nunera/Determine/cloud/inference/requirements-cpu.txt

# Local development / smoke test on CPU (no Neuron devices). Install torch from the CPU index:
#   pip install --index-url https://download.pytorch.org/whl/cpu torch
torch
transformers>=4.57
pillow
num2words
