nunera/Determine/cloud/API.md

# Describe loop — cloud contract v1 (Arch §7.3)

Optional, on-request scene description. Never in the hazard loop: the phone keeps warning while a request is in
flight, and any MID or NEAR hazard interrupts the answer.

```
phone ──HTTPS──▶ describe-api (AWS Lambda, arm64 / Graviton2) ──HTTP──▶ inference server (EC2 inf2.xlarge, Inferentia2)
                                                    └──(optional fallback)──▶ Amazon Bedrock Nova Lite (silicon not guaranteed)
                                                    └──(configured primary)─▶ OpenRouter → configured vision model
```

## 1. Phone → describe-api

`POST /v1/describe` · `Authorization: Bearer <DESCRIBE_API_KEY>` · `Content-Type: application/json`

Request:

| Field | Type | Rule |
|---|---|---|
| `request_id` | string | 8–64 chars `[A-Za-z0-9_-]`, chosen by the phone |
| `image_jpeg_b64` | string | base64 JPEG, decoded size ≤ 512 KiB, must start `FFD8` |
| `width`, `height` | int | 16–2048 |
| `redacted` | bool | `true`: the phone blurred faces before upload. `false` is accepted only together with `unredacted_opt_in: true`, otherwise 400 |
| `unredacted_opt_in` | bool, optional | `true` only when the wearer has explicitly opted in to uploading frames with faces unblurred (default off in the app). Ignored when `redacted` is `true` |
| `question` | string, optional | A specific question about the photo (1–300 characters of plain text; double quotes become single). It is added to the §3 prompt as data, and the answer still passes the §3 filter. Never logged |
| `locale` | string | `en` only in v1 |

Response 200:

```json
{"request_id":"…","text":"A doorway is open on your right. A person is farther ahead near the wall.",
 "sentences":["A doorway is open on your right.","A person is farther ahead near the wall."],
 "model":"HuggingFaceTB/SmolVLM-256M-Instruct","backend":"inf2","silicon":"Inferentia2",
 "timings_ms":{"inference":812,"api":43,"total":855}}
```

- `backend` ∈ `inf2` | `trn2` | `bedrock` | `openrouter` | `cpu` (dev only). `silicon` ∈ `Inferentia2` | `Trainium2` | `unspecified` | `CPU`. With `openrouter` the `model` is the model OpenRouter actually served.
- `text` is at most 2 sentences, ≤ 240 characters, after the API's safety filter (§3). The phone speaks it as
  returned; neither the API nor the phone adds a prefix.
- Errors: JSON `{"request_id":…|null,"error":"<code>","retryable":bool}` with status 400 `bad_request`,
  401 `unauthorized`, 413 `too_large`, 502 `inference_failed`, 503 `unavailable`, 504 `timeout`.
- The API stores no images and logs no image bytes or text; it logs request_id, sizes, backend and timings.
- Phone timeout: 8 s end to end. API → inference timeout: 6 s.

### 1b. Voice routing: `POST /v1/voice`

Same bearer key and error format. What the wearer said after the wake phrase goes to Jev, TypeSafe's decision model
(`typesafe/jev-1.14`, set with `OPENROUTER_ROUTER_MODEL`), through OpenRouter's Decisions API
(`POST https://openrouter.ai/api/alpha/decisions`). Jev is not a chat model: it answers one typed Choice question,
"which of these routes does the wearer want", with the chosen route and a probability for every route, in about 0.3 s
(measured from the home server). Only the transcript text is sent: no audio and no image. The phone tries its own
fixed phrases first and calls this only when none matched.

Request: `{"request_id":str,"transcript":str (1–300 chars),"locale":"en"}`

Response 200:

```json
{"request_id":"…","action":"command","command":"pauseWarnings","model":"typesafe/jev-1.14-20261014","backend":"openrouter",
 "confidence":0.99,"timings_ms":{"inference":270,"api":3,"total":273}}
```

- Routes: `whatsAhead`, `readText`, `pauseWarnings`, `resumeWarnings`, `stopSpeaking`, `askAboutScene`, `none`.
- `action` is `command` (the first five routes), `ask` (`askAboutScene`: the phone then calls `/v1/describe` with one
  frame and `question`, which is what the wearer said as cleaned plain text), or `none`. `confidence` is Jev's
  probability for the chosen route.
- "Is this path safe / clear / okay to cross?" routes to `whatsAhead`, not `askAboutScene`: a photo cannot show that
  something is safe, and the §3 filter drops any sentence that says so, so a yes-or-no question would come back empty
  or missing the hazard. The wearer gets the same description as for "what's ahead", which never says safe or clear.
- The route is acted on only when `confidence` ≥ `VOICE_MIN_CONFIDENCE` (default 0.6); otherwise `action` is `none`.
  Anything else unusable (a route that is not one of the seven, a missing or non-numeric probability, a malformed
  answer) is also `none`: the phone does nothing.
- The transcript is untrusted but cannot instruct anything: it is Jev's state, and the only possible output is one of
  the seven routes. It is never logged; only its length is. The Decisions API has no data-collection option, so the
  transcript goes to TypeSafe under OpenRouter's default policy.
- Budget 4 s; failures use the same codes (`unavailable` for a missing key, rate limit or no credits, `timeout`).

### 1c. Streamed descriptions: `POST /v1/describe/stream`

Implemented by `describe-api/local_server.py` with `DESCRIBE_BACKEND=openrouter`. The Lambda handler and its
existing JSON endpoint remain buffered; deploying the SAM template alone does not enable this streaming route.
Same bearer key, image limits, locale and privacy validation as §1. Additional request fields:

| Field | Choices | Default |
|---|---|---|
| `length` | `brief` (1 sentence / 180 characters), `standard` (2 / 360), `detailed` (5 / 1000) | `standard` |
| `style` | `direct`, `conversational`, `spatial` (image positions, not walking directions) | `direct` |

The prompt applies these preferences. Before emission, every complete sentence passes the existing reassurance
and person-attribute heuristics. The first increment therefore waits for a complete sentence, not just a token.
These heuristics are conservative checks, not safety certification. No unfiltered token is emitted first.

Response: `Content-Type: application/x-ndjson`, `Cache-Control: no-store`; each line is one JSON object:

```json
{"type":"delta","text":"A chair is on the left."}
{"type":"delta","text":" A door is ahead."}
{"type":"done","text":"A chair is on the left. A door is ahead.","request_id":"example_123"}
```

Concatenate deltas exactly (including leading spaces); `done.text` must equal that concatenation.
Failures before the first safe sentence use the ordinary JSON/status contract. A later failure sends
`{"type":"error","error":"inference_failed","retryable":true}` and closes the stream, with no `done`.
An EOF without `done` is a failure, not a complete answer. Cancelling the client closes its connection;
the server closes upstream on its next attempted write. The upstream request has a 20 s socket timeout and
checks elapsed time between events; the client has a 25 s idle / 45 s resource timeout. No automatic retries.
OpenRouter cancellation/billing depends on its selected upstream provider.
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
