nunera/Determine/docs/images/brief-2.png

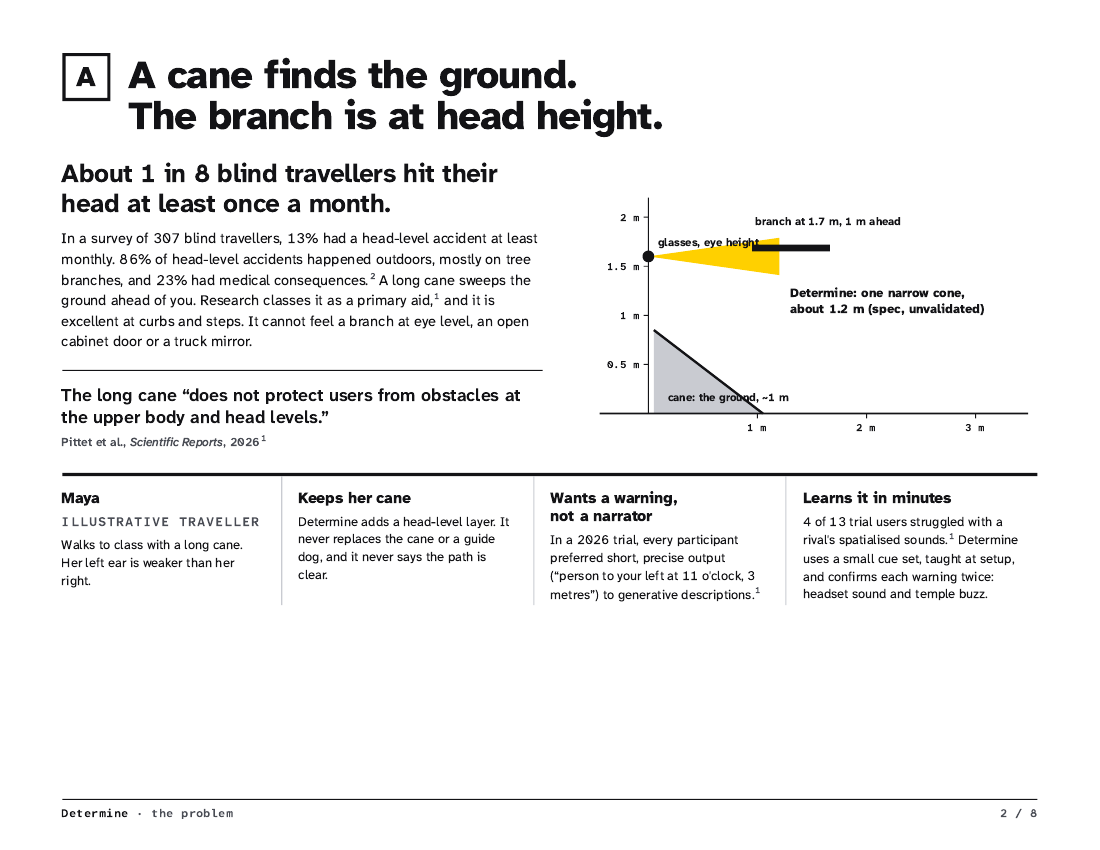
docs/images/brief-2.png
