nunera/Determine/docs/images/brief-5.png

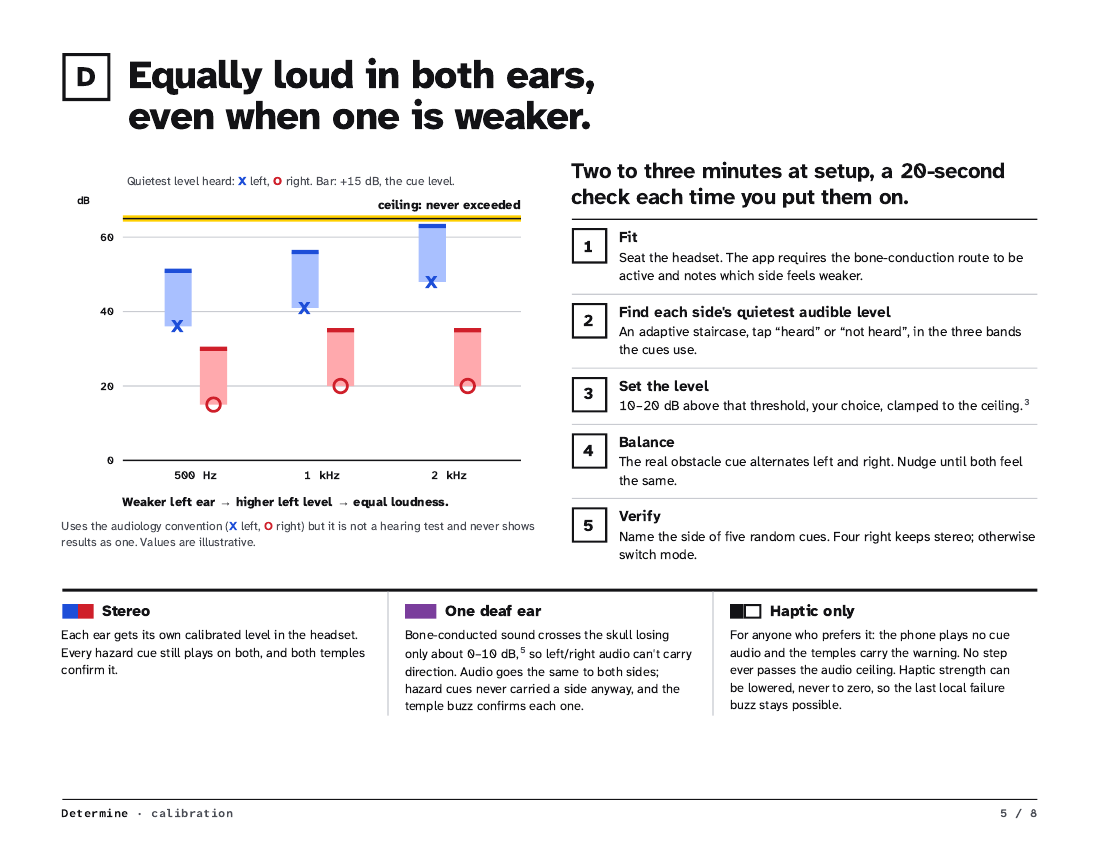
docs/images/brief-5.png
