nunera/Determine/docs/images/brief-7.png

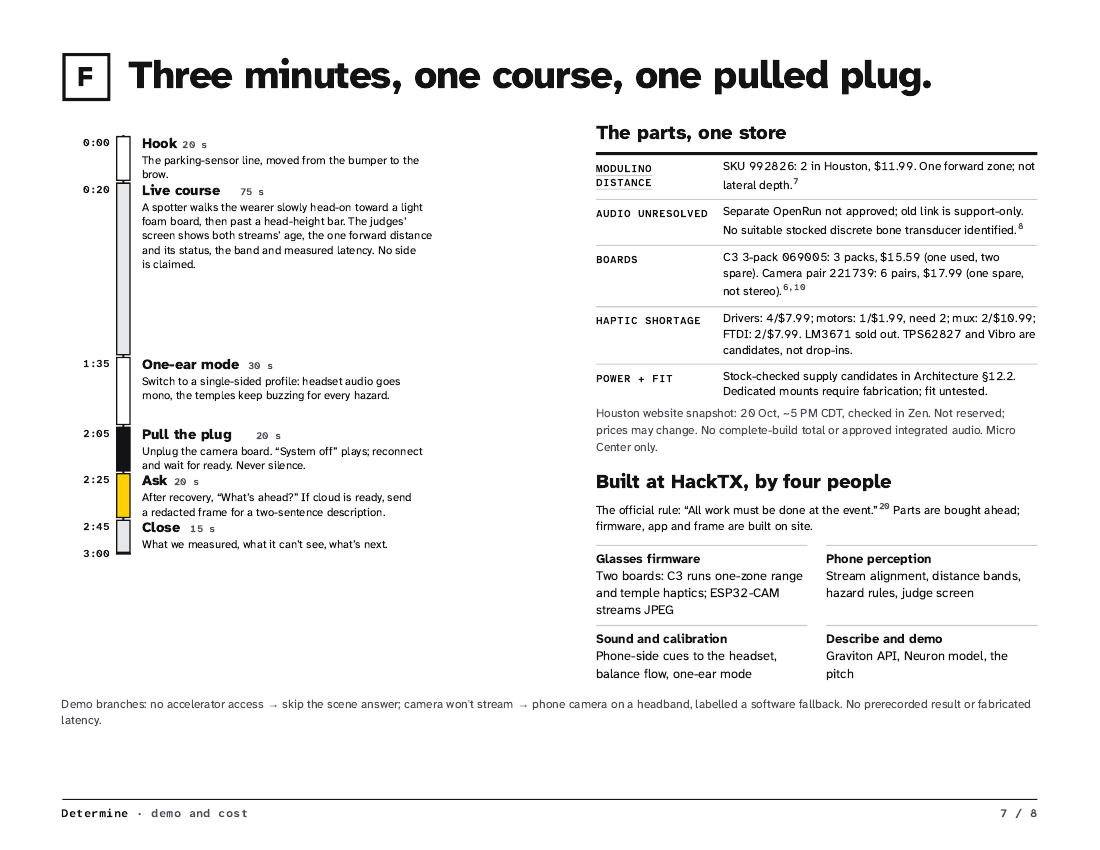
docs/images/brief-7.png
