nunera/Determine/docs/images/brief-8.png

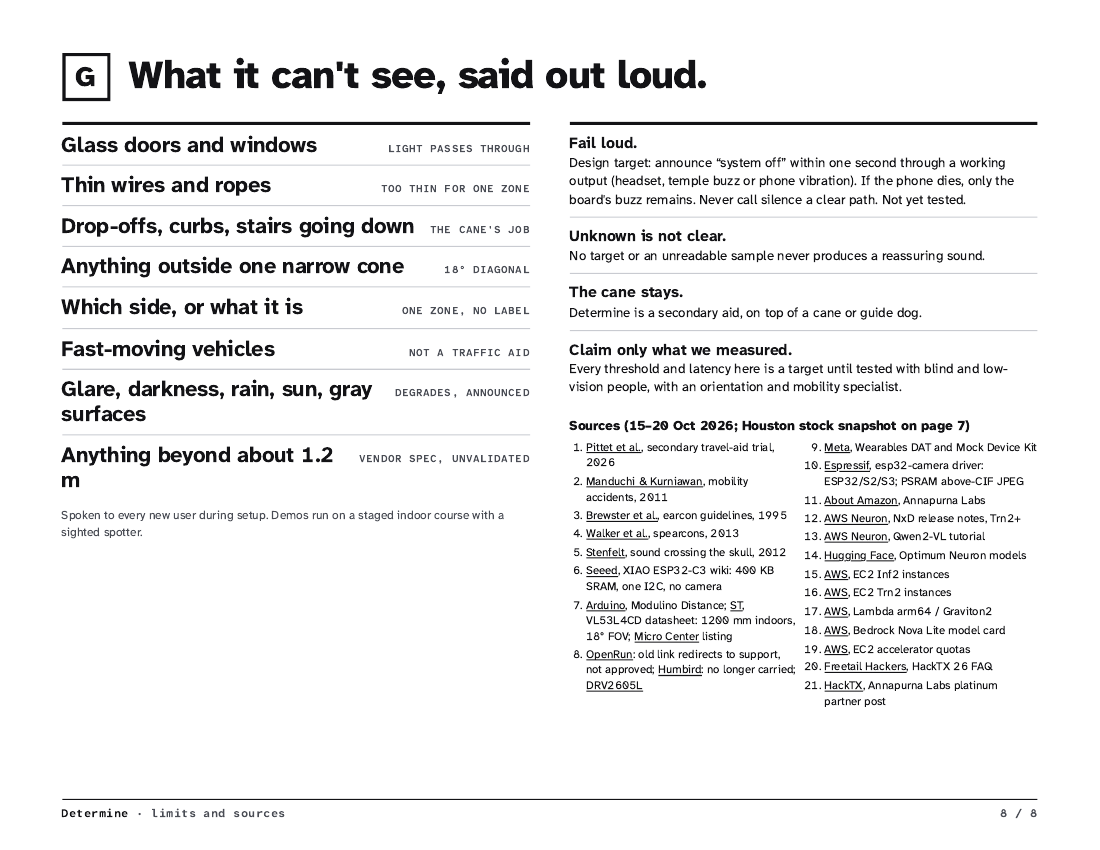
docs/images/brief-8.png
