nunera/Determine/docs/images/desktop-judge-near.png

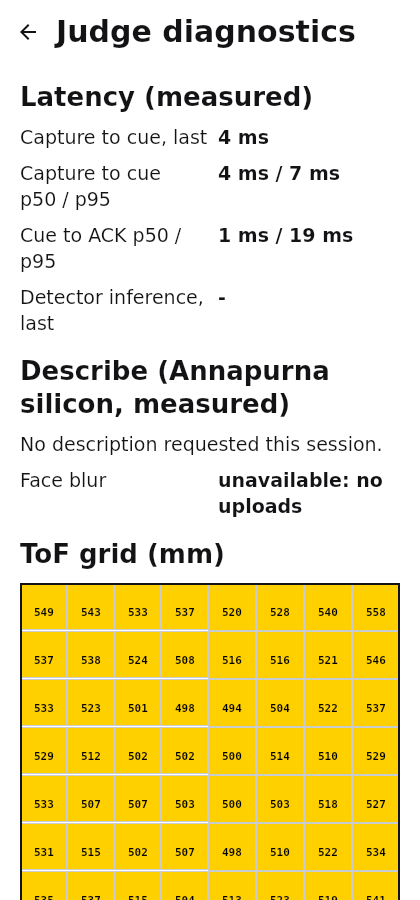
docs/images/desktop-judge-near.png
