nunera/Determine/docs/images/desktop-judge.png

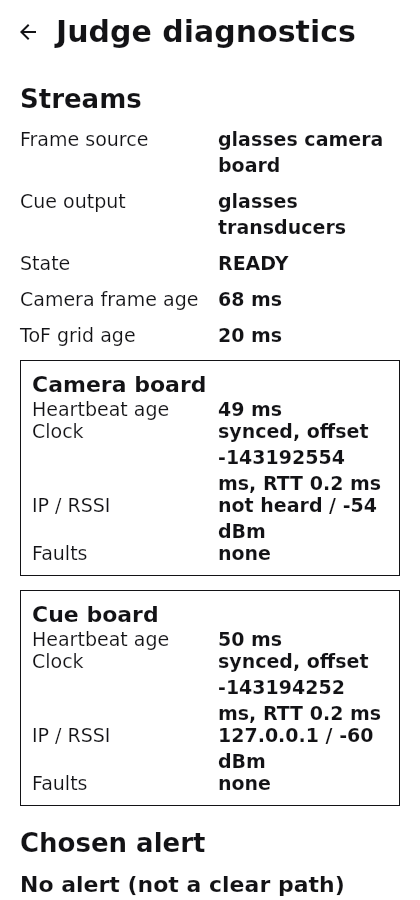
docs/images/desktop-judge.png
