nunera/Determine/docs/images/desktop-main.png

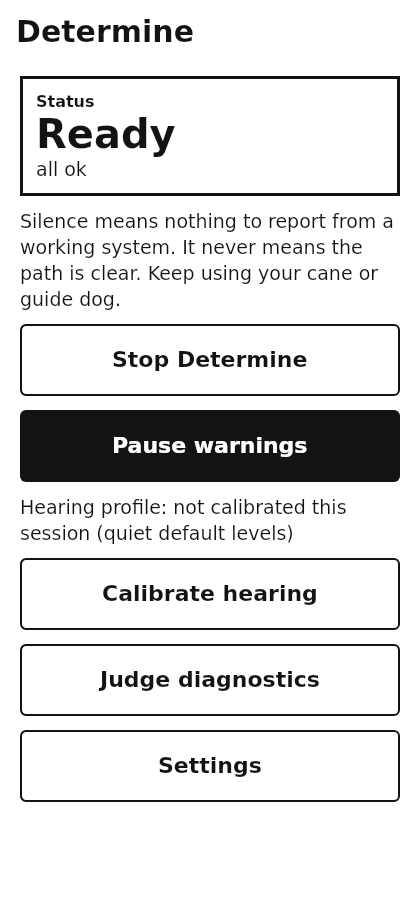
docs/images/desktop-main.png
