nunera/Determine/web/public/model/Right_LensFrontWindow.stl

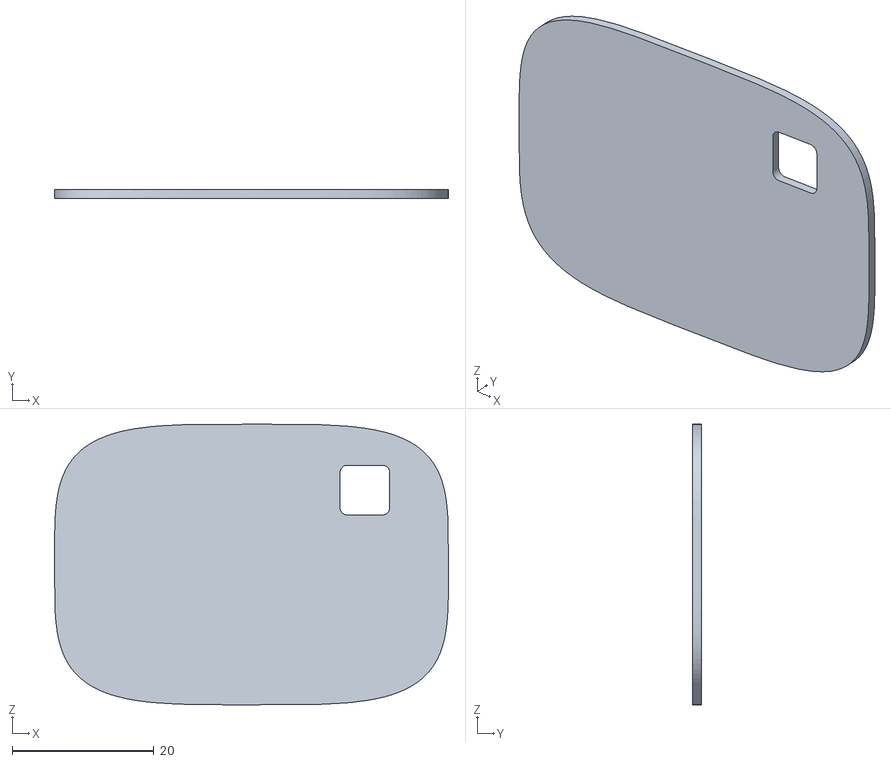
[picture p21: CAD file, 2026-10-25]
web/public/model/Right_LensFrontWindow.stl
55.6 x 1.20 x 39.6
