nunera/Determine/web/public/model/Left_HingePin.stl

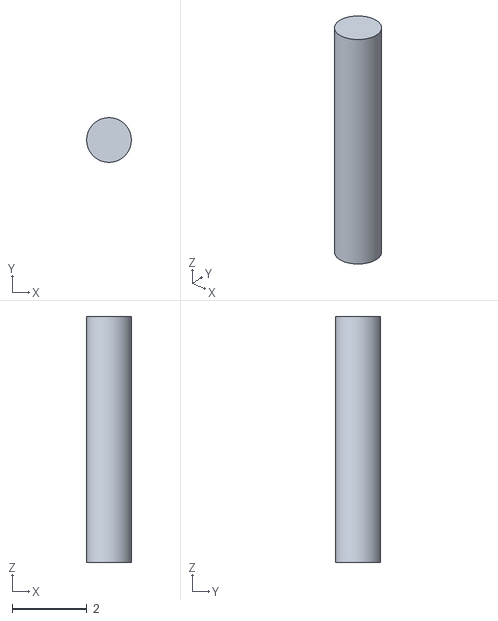
[picture p22: CAD file, 2026-10-25]
web/public/model/Left_HingePin.stl
1.20 x 1.20 x 6.60
