nunera/Determine/web/public/model/Right_RemovableTempleCover.stl

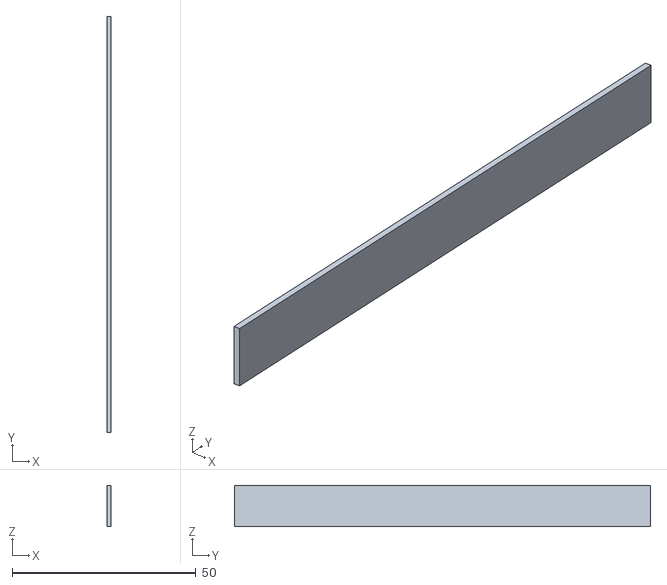
[picture p23: CAD file, 2026-10-25]
web/public/model/Right_RemovableTempleCover.stl
1.20 x 113.2 x 11.2
