nunera/Determine/web/public/model/Left_LensChamber.stl

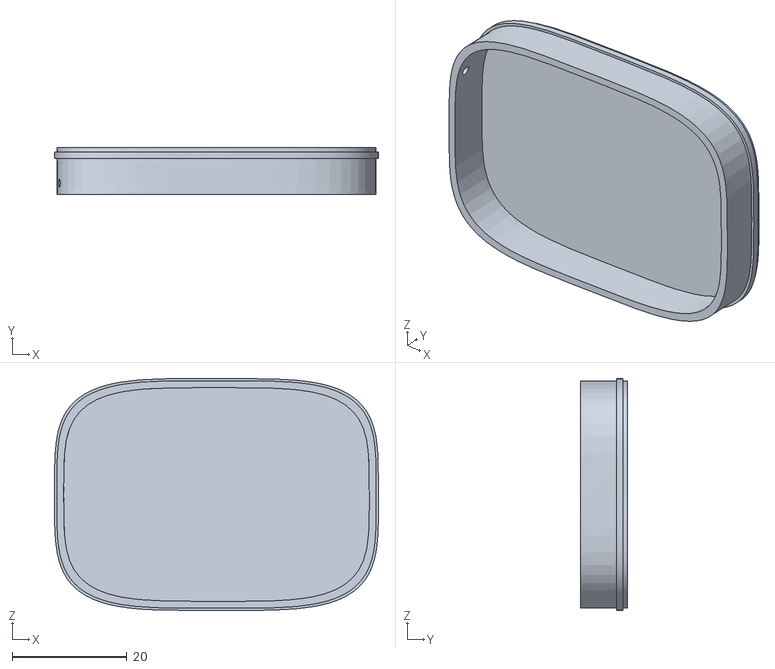
[picture p24: CAD file, 2026-10-25]
web/public/model/Left_LensChamber.stl
56.4 x 8.10 x 40.4
