nunera/Determine/web/public/model/Left_ClearTemple.stl

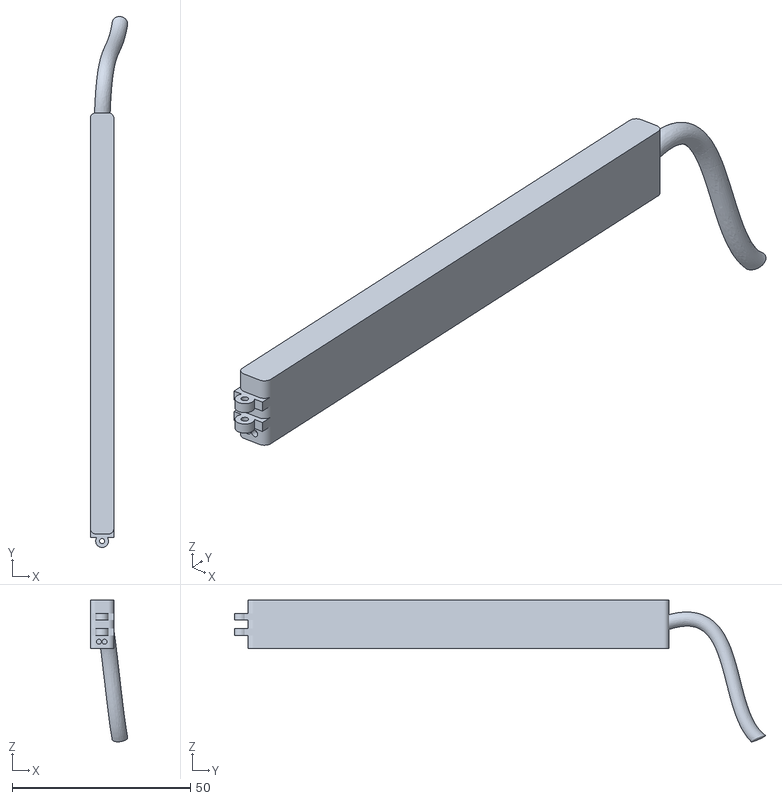
[picture p25: CAD file, 2026-10-25]
web/public/model/Left_ClearTemple.stl
10.5 x 148.8 x 39.7
