nunera/Determine/web/public/model/ForwardCamera_OpticalGasket.stl

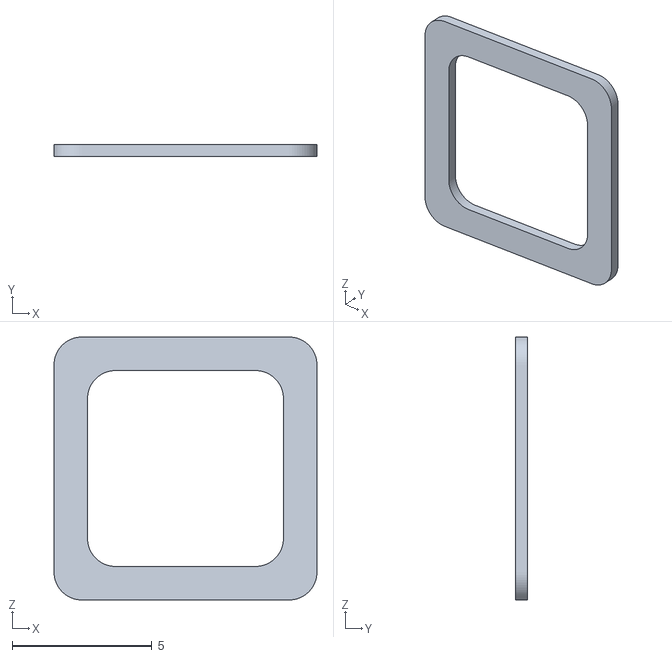
[picture p26: CAD file, 2026-10-25]
web/public/model/ForwardCamera_OpticalGasket.stl
9.40 x 0.43 x 9.40
