nunera/Determine/web/public/model/Front_ClearFrame.stl

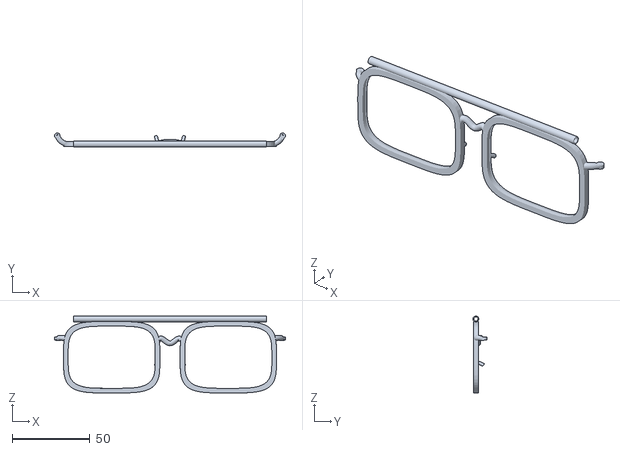
[picture p27: CAD file, 2026-10-25]
web/public/model/Front_ClearFrame.stl
148.6 x 9.10 x 49.5
