nunera/Determine/web/public/model/Left_NosePad.stl

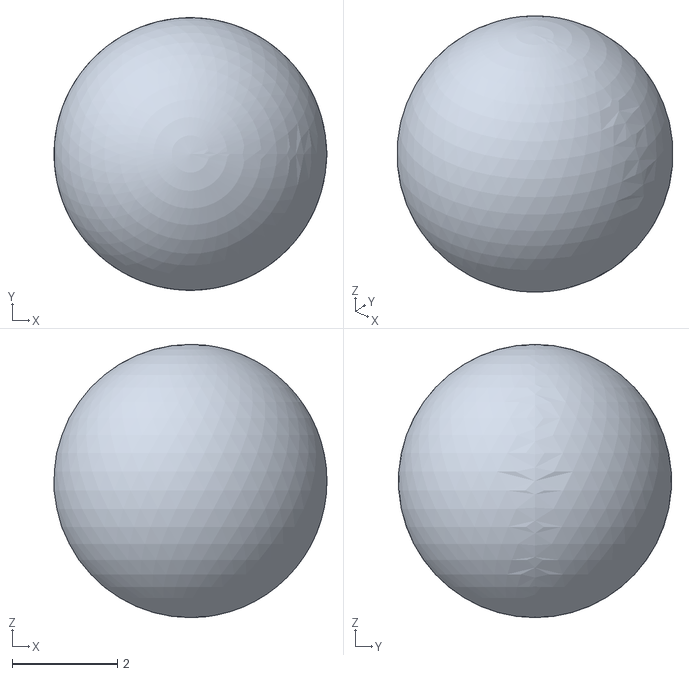
[picture p28: CAD file, 2026-10-25]
web/public/model/Left_NosePad.stl
5.19 x 5.18 x 5.20
