nunera/Determine/web/public/model/ForwardToF_OpticalGasket.stl

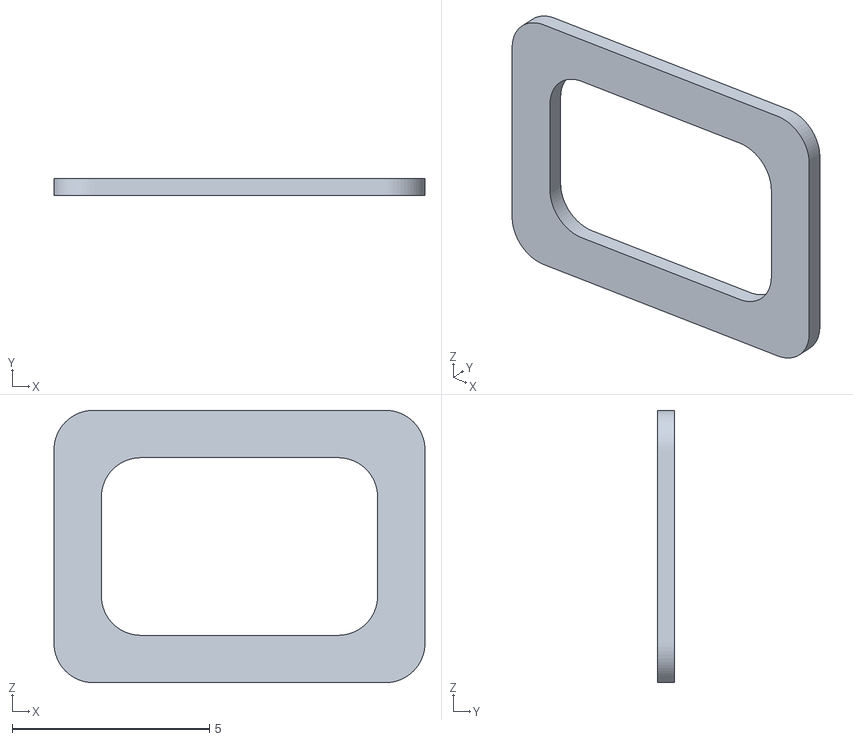
[picture p29: CAD file, 2026-10-25]
web/public/model/ForwardToF_OpticalGasket.stl
9.40 x 0.43 x 6.90
