nunera/Determine/(list of files, cad)

Other CAD files:
web/public/model/Right_LensChamber.stl
web/public/model/Right_HingePin.stl
web/public/model/Left_LensFrontWindow.stl
web/public/model/Right_ClearTemple.stl
web/public/model/Left_RemovableTempleCover.stl
web/public/model/Right_NosePad.stl
