nunera/Determine/docs/visual-guide/assets/simulation.png

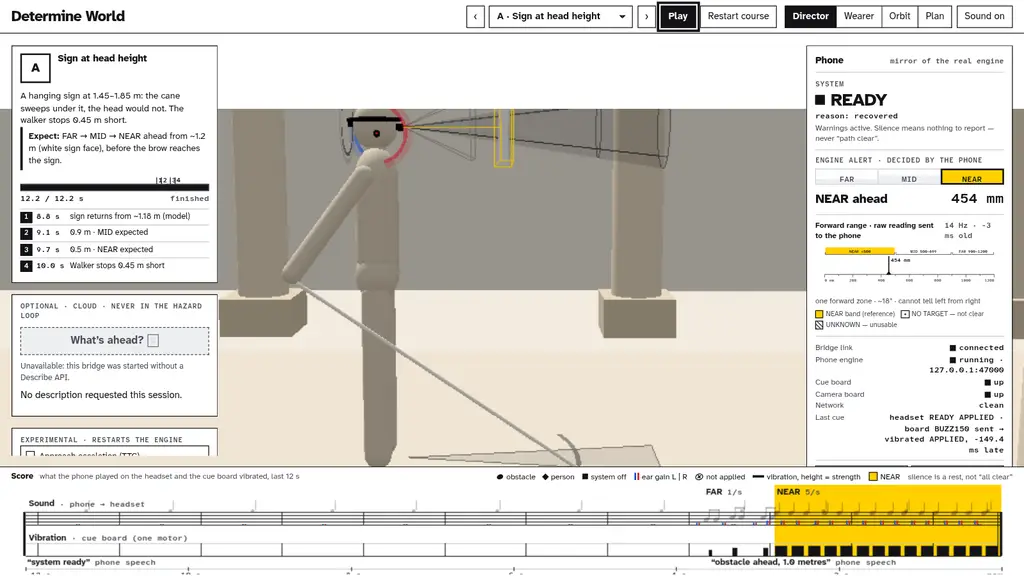
docs/visual-guide/assets/simulation.png
