nunera/Determine/firmware/common/include/secrets.example.h

// Copy to secrets.h (gitignored) and fill in the phone hotspot credentials.
// Arch §10.1: WPA2 hotspot with a unique password.
#pragma once
#define DT_WIFI_SSID "determine-hotspot"
#define DT_WIFI_PASS "change-me-unique"
