nunera/Determine/(commit log)

2026-10-24 Document compact Houston-first parts list
    Add the full compact two-board purchase list (Architecture §12.2), compact headband layout and power notes, matching brief parts and diagram, and product context. Regenerate both PDFs.
2026-10-24 Audit docs for consistency and add Annapurna collaboration research
    - Fix stale price total, power-loss wording, ESP32-CAM status, latency budget
    - NEAR cue becomes one urgent note at 5/s (fits the 6 notes/s rule)
    - Optional MOSFET haptic fallback parts; canonical six-segment demo script
    - Brief layout fixes (clipped/overlapping labels, footer overflow, rest glyph font)
    - New Architecture §11.6: Annapurna Labs collaborations; Gemma3 as second Inf2 candidate
2026-10-24 Add wire protocol v1, ESP32 firmware, simulator and flow diagrams
    - protocol/: PROTOCOL.md, Python reference codec, golden vectors
    - firmware/cue-board (XIAO ESP32-C3) and firmware/cam-board (ESP32-CAM), PlatformIO, native Unity tests
    - tools/sim: two-board simulator, bench tool for real boards, end-to-end harness (8 scenarios)
    - docs/flows: 6 hardware flow maps and 9 software flowcharts, rendered SVGs; README gallery with brief pages
2026-10-24 Add phone hazard engine and headless CLI
    - phone/core: wire codec, clock sync, frame assembly, ToF corridor, hazard policy (Arch §7.2),
    cue scheduler (Arch §8), calibration (Arch §9), system states (Arch §4.2)
    - Tier 0 phone-camera and phone-audio cue fallbacks; Describe controller (opt-in, interruptible)
    - phone/cli: determine-phone, stable event output for tools/sim/e2e.py (8/8 scenarios pass)
2026-10-24 Add Android app
    Foreground service, MediaPipe detector, TTS/vibration, judge + calibration + settings UI.
    Describe: long-press 'What's ahead?', BlazeFace face blur on the phone, HTTPS client, spoken 'May be wrong.'
    Fallbacks: CameraX phone camera (Tier 0) and phone-audio cue sink, labelled as software fallbacks.
2026-10-24 Add Describe loop on Annapurna silicon
    - cloud/API.md contract; describe-api on Lambda arm64 (Graviton2) with SAM template and safety filter
    - inference server for SmolVLM-256M via optimum-neuron on inf2.xlarge, compile + setup + bench scripts
    - CPU dev path measured end to end (p50 2.0 s); Inferentia2 unmeasured until quota
2026-10-24 Fix camera-reboot lockout and emulator crash; add app screenshots
    - phone/core: after a board reboot or reconnect, reset its clock sync and (camera) frame history.
    Before, a camera that restarted frame_id at 0 kept the system UNAVAILABLE ('frame stale') until the
    new count passed the old one. Regression test fails before, passes after; verified on the emulator.
    - android: a missing MediaPipe native library (e.g. x86_64) now degrades to ToF-only / no Describe
    uploads instead of crashing the service (LinkageError was not caught).
    - README: app screenshots from the emulator driven by the simulator.
    [Engine.kt, EngineTest.kt]
2026-10-25 ios: add native SwiftUI prototype with unsigned xtool IPA build
2026-10-25 Bring iOS app live with tuning, diagnostics, OCR and Vibro firmware
    Port the phone engine and UDP runtime to Swift, add experimental controls and live Judge diagnostics, and update hardware documentation and simulator coverage. Record exploration mode as unresolved after real-device feedback.
2026-10-25 Add Determine World simulator, experiments and visual technical guide
    * WIP: Determine World simulator, bridge and research docs
    * Complete wire-v2 Determine World, experiment exports and illustrated research
2026-10-25 Add desktop test app sharing the Android app's UI and engine; nix run launchers (#2)
    - app-shared/: the screens, navigation, runtime, EngineHost, DetermineSession, UDP link, Describe client
    and phone-audio cue core, moved out of the Android app and compiled into both apps (git mv, history kept).
    Device pieces sit behind HostPlatform / AppPlatform.
    - desktop/: Compose Multiplatform app on the same code; Java Sound cues, espeak-ng speech; no detector,
    face blur or phone camera (judge screen says so; Describe uploads refused).
    - flake.nix: nix run .#desktop -- --sim SCENARIO --start, and nix run .#android-demo (real APK in an
    emulator, --headless), plus nix develop.
    - tools/sim: --loop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
2026-10-25 Add Describe on iOS with explicit unblurred-upload opt-in
    The describe-api accepts redacted=false only together with unredacted_opt_in=true. The iPhone app sends one fresh camera frame on request to a configurable server (key in Keychain), speaks the answer prefixed 'May be wrong.', and is cut by MID/NEAR warnings. Marks exploration mode working per user report.
2026-10-25 cue-board: set the Vibro's own duration to the pattern segment so pulses stop on time
    A fixed 1000 ms module-side window plus an OFF write made short cues feel long and inconsistent on the bench; modes with an exact module-side duration felt like soft taps.
    [main.cpp]
2026-10-25 Speak Read text and Describe answers as returned, without the 'may be wrong' prefix
    Product decision: users are told answers can be wrong during onboarding. Removes the prefix from the iOS app, the shared Kotlin DescribeController (DescribeConfig.prefix is gone), the world bridge, and the contract and flow docs. Bumps the iOS app to 0.3.1 (4).
2026-10-25 ios: on-device 'Hey Determine' wake word with Apple's SpeechAnalyzer
    Opt-in (default off). Listens on the built-in microphone with Bluetooth output kept on A2DP, understands what's ahead, read text, pause, resume and stop, and runs them through the same VoiceCommand path as Siri. Phrase parsing lives in DetermineEngine with unit checks; the microphone and recognizer are compile-verified only. Version 0.5.0 (6).
2026-10-25 describe-api: OpenRouter vision backend, scene questions and a /v1/voice router
    DESCRIBE_BACKEND=openrouter sends one frame to any OpenRouter vision model (default openai/gpt-6-luna) with data_collection=deny. Describe accepts an optional question. POST /v1/voice sends only the transcript to a router model (default typesafe/jev-router) with run_command / ask_about_scene / no_action tools; anything unusable means do nothing. Adds a bake-off script.
2026-10-25 Voice routing with Jev (Decisions API), scene questions on iOS, wake-word AI understanding
    /v1/voice now asks Jev one Choice question and acts only above a probability threshold (0.6), instead of a router chat model with tools; measured about 0.3 s. The iOS wake word sends words that match no fixed phrase to it when the new Settings switch is on, and a scene question uploads one frame with the question. Adds the probe and bake-off scripts. Version 0.6.0 (7).
2026-10-25 describe-api: safety and clearness questions go to the camera and are answered by describing what is there
    Jev routed 'is this path safe' to none, so the app said it did not get that. The askAboutScene route now covers it, and the question prompt tells the vision model not to judge safety or use safe/clear/empty but to say what it sees.
2026-10-25 describe-api: 'is this path safe/clear' routes to the plain description
    The question prompt variant made the model say safe or clear, the filter dropped those sentences, and the answer came back empty or missing the hazard. Jev's whatsAhead route now covers safety questions; askAboutScene keeps specific questions.
2026-10-25 Add streaming speech, polished iOS controls, and camera mirror correction
2026-10-25 Add Determine product website and live engineering studio
    [ForwardCamera_OpticalGasket.stl, ForwardToF_OpticalGasket.stl, Front_ClearFrame.stl, Left_ClearTemple.stl, Left_HingePin.stl, Left_LensChamber.stl, Left_LensFrontWindow.stl, Left_NosePad.stl]
